chupachupbum/smart-coaster/docs/app-screens/01_dashboard.png

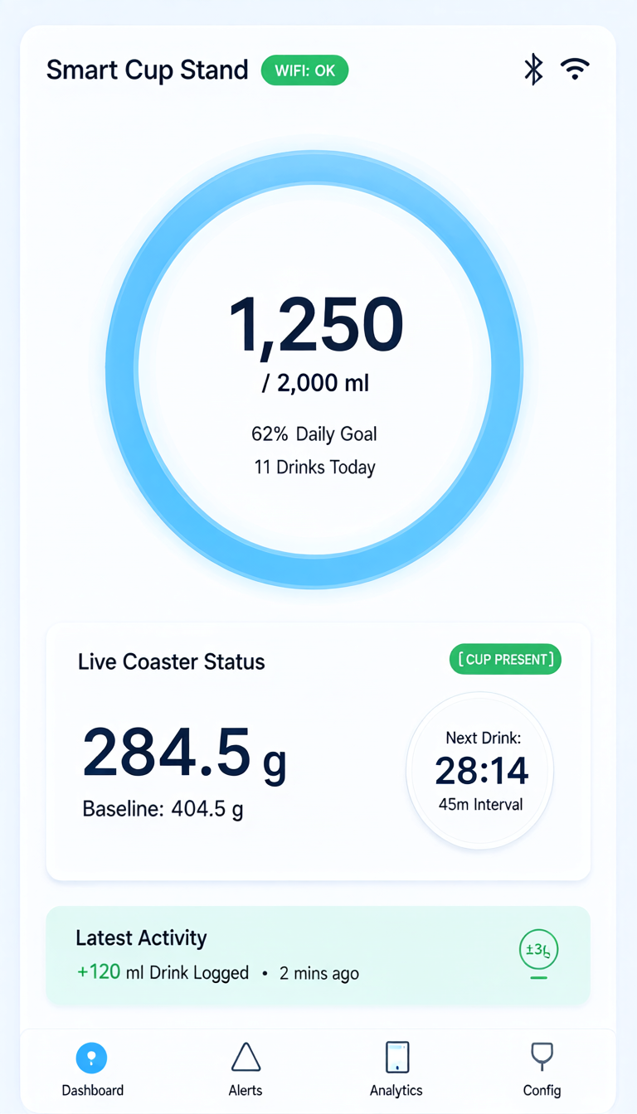
docs/app-screens/01_dashboard.png
