chupachupbum/smart-coaster/docs/app-screens/02_notifications.png

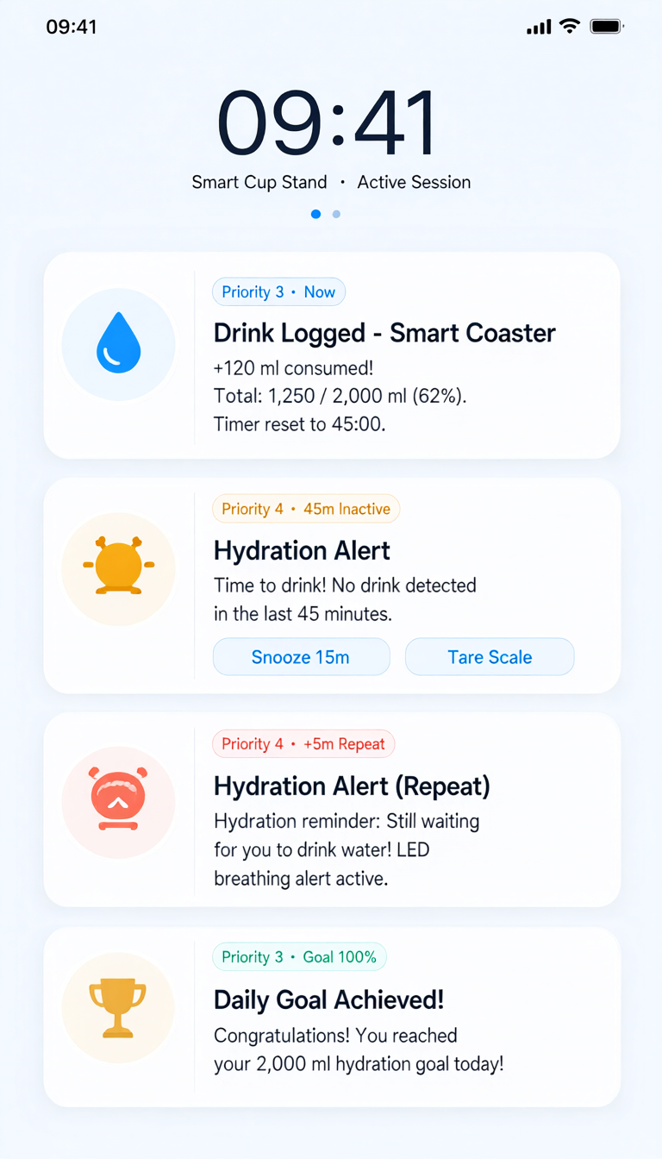
docs/app-screens/02_notifications.png
