chupachupbum/smart-coaster/docs/app-screens/03_charts_analytics.png

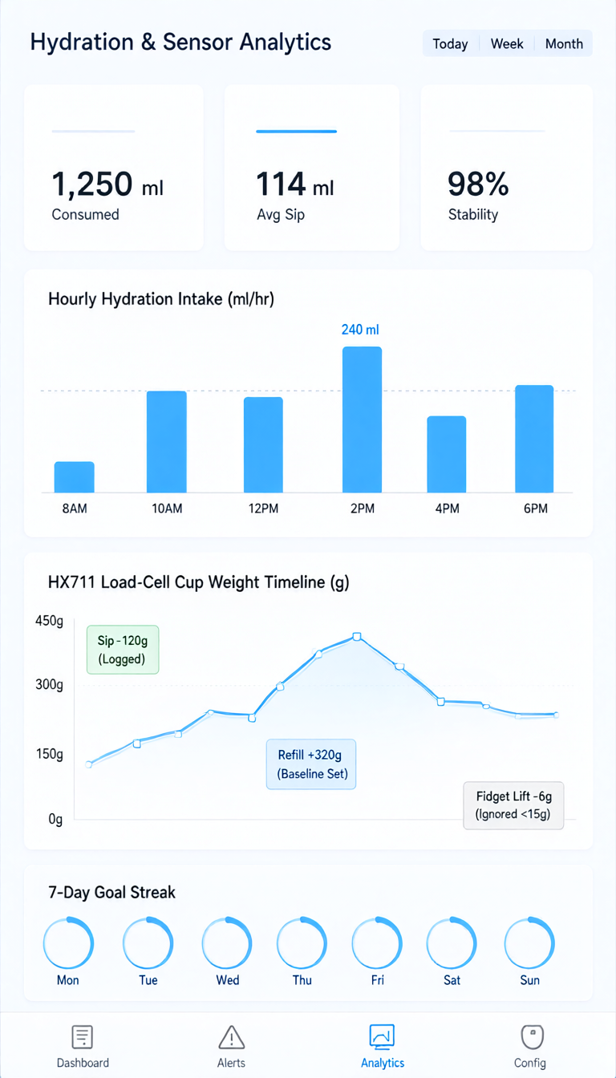
docs/app-screens/03_charts_analytics.png
