chupachupbum/smart-coaster/docs/app-screens/04_configuration.png

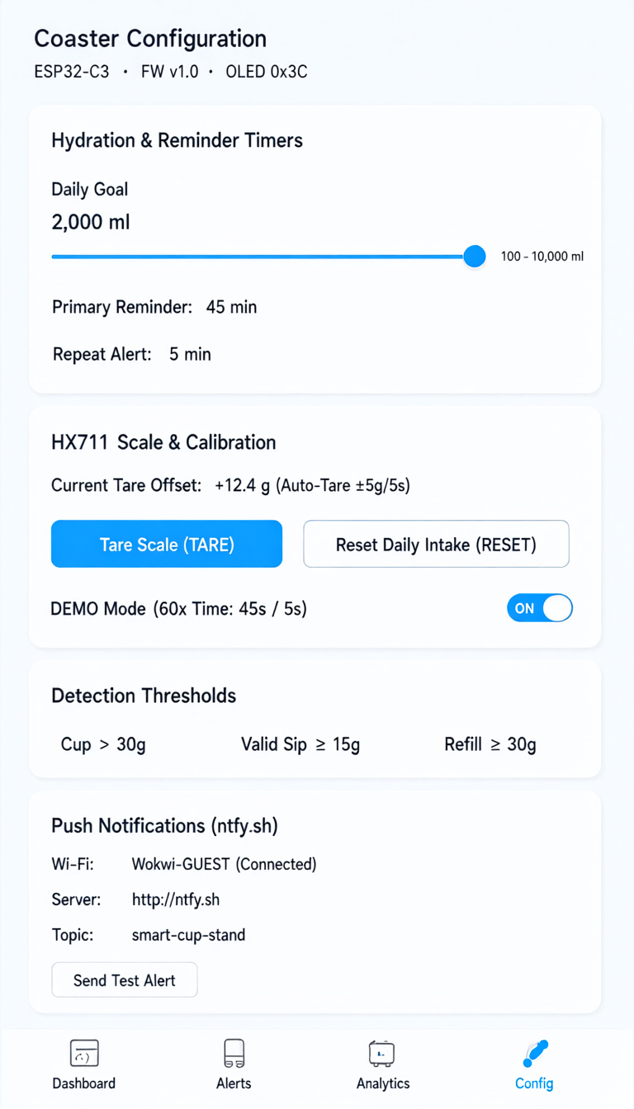
docs/app-screens/04_configuration.png
