chupachupbum/smart-coaster/schematic.jpeg

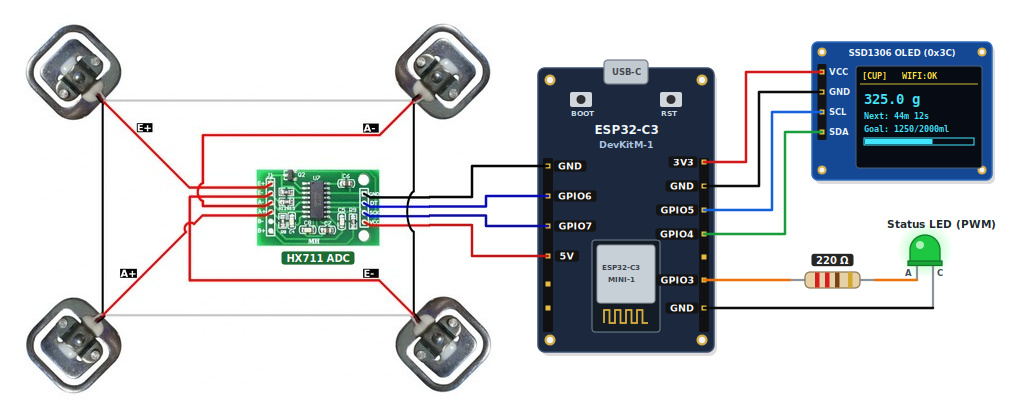
schematic.jpeg
