chupachupbum/smart-coaster/schematic_round_coaster.jpeg

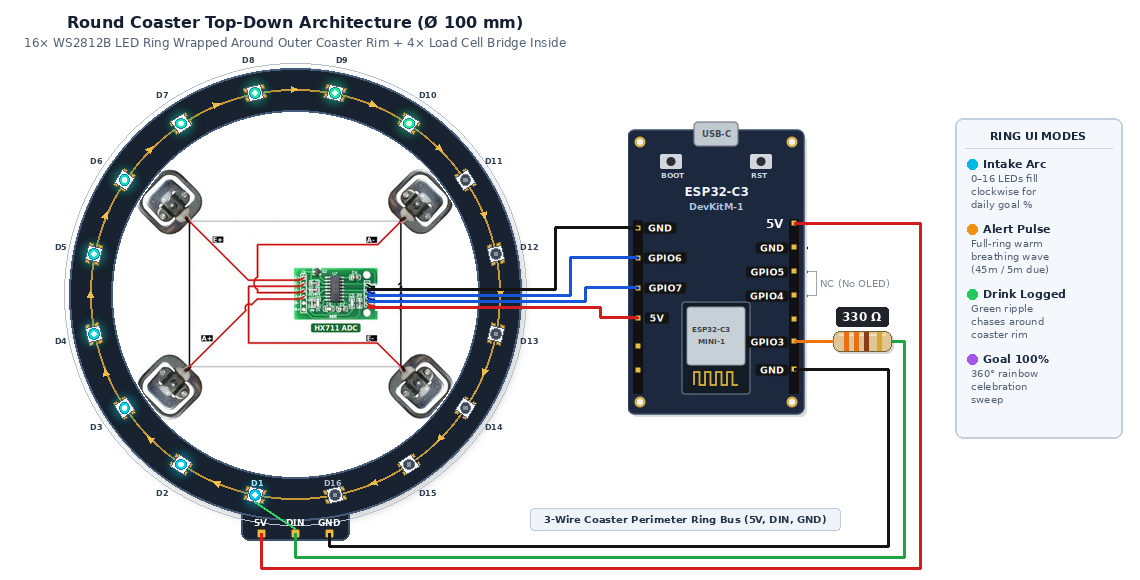
schematic_round_coaster.jpeg
