chupachupbum/smart-coaster/hardware/smart_cup_stand_pcb/manufacturing/bom.csv

Reference | Value | Footprint | Quantity | LCSC Part Number
C1, C2, C3, C4 | 10uF | Capacitor_SMD:C_0805_2012Metric | 4 | C15850
C5, C6, C7, C8, C9, C10, C11 | 100nF | Capacitor_SMD:C_0603_1608Metric | 7 | C14663
J1 | TYPE-C-31-M-12 | Connector_USB:USB_C_Receptacle_HRO_TYPE-C-31-M-12 | 1 | C165948
J2 | Conn_01x04_Pin | Connector_PinHeader_2.54mm:PinHeader_1x04_P2.54mm_Horizontal | 1 | C492412
J3 | Conn_01x03_Pin | Connector_PinHeader_2.54mm:PinHeader_1x03_P2.54mm_Horizontal | 1 | C492411
Q1 | SS8550 | Package_TO_SOT_SMD:SOT-23 | 1 | C2145
R1, R2 | 5.1k | Resistor_SMD:R_0603_1608Metric | 2 | C23186
R3, R4, R5, R6 | 10k | Resistor_SMD:R_0603_1608Metric | 4 | C25804
R7 | 330 | Resistor_SMD:R_0603_1608Metric | 1 | C23138
R8 | 20k | Resistor_SMD:R_0603_1608Metric | 1 | C4184
R9 | 8.2k | Resistor_SMD:R_0603_1608Metric | 1 | C23254
R10, R11 | 100 | Resistor_SMD:R_0603_1608Metric | 2 | C22775
SW1, SW2 | SW_Push | Button_Switch_SMD:SW_SPST_TL3342 | 2 | C318884
U1 | ESP32-C3-WROOM-02 | RF_Module:ESP32-C3-WROOM-02 | 1 | C2934560
U2 | AMS1117-3.3 | Package_TO_SOT_SMD:SOT-223-3_TabPin2 | 1 | C6186
U3 | HX711 | Package_SO:SOIC-16_3.9x9.9mm_P1.27mm | 1 | C43656
