chupachupbum/smart-coaster/hardware/smart_cup_stand_pcb/manufacturing/renders/pcb_cad_3d_bottom.png

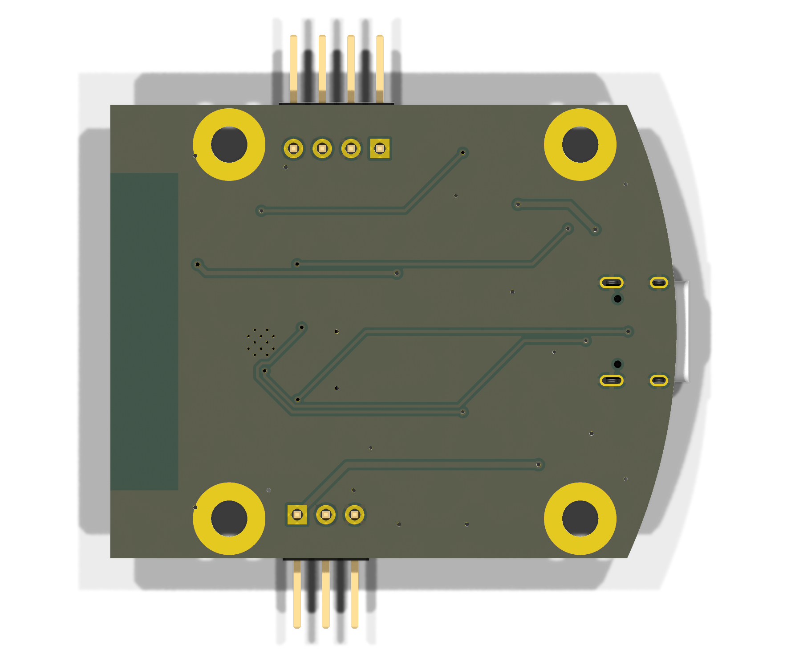
hardware/smart_cup_stand_pcb/manufacturing/renders/pcb_cad_3d_bottom.png
