chupachupbum/smart-coaster/hardware/smart_cup_stand_pcb/manufacturing/renders/pcb_reallife_top.jpg

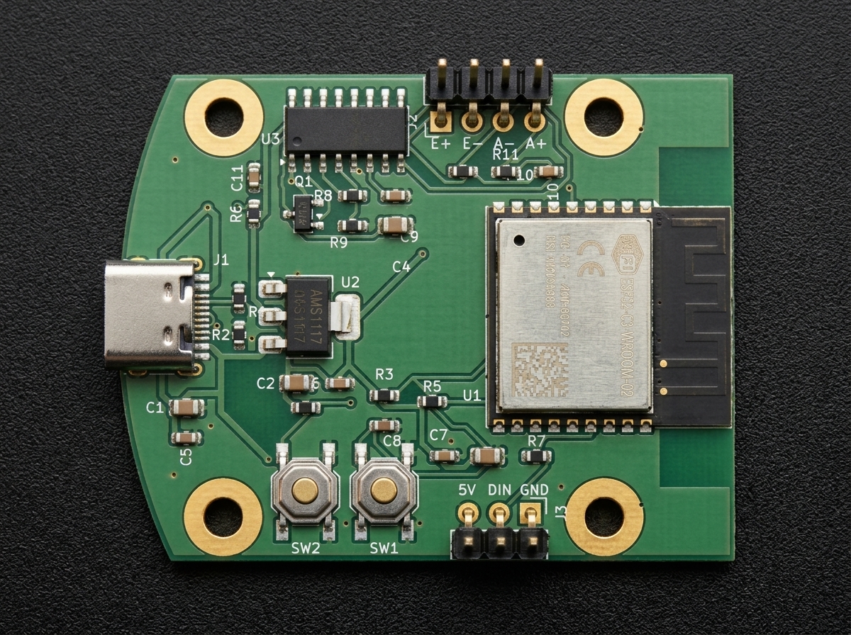
hardware/smart_cup_stand_pcb/manufacturing/renders/pcb_reallife_top.jpg
