chupachupbum/smart-coaster/hardware/smart_cup_stand_pcb/manufacturing/schematic.pdf

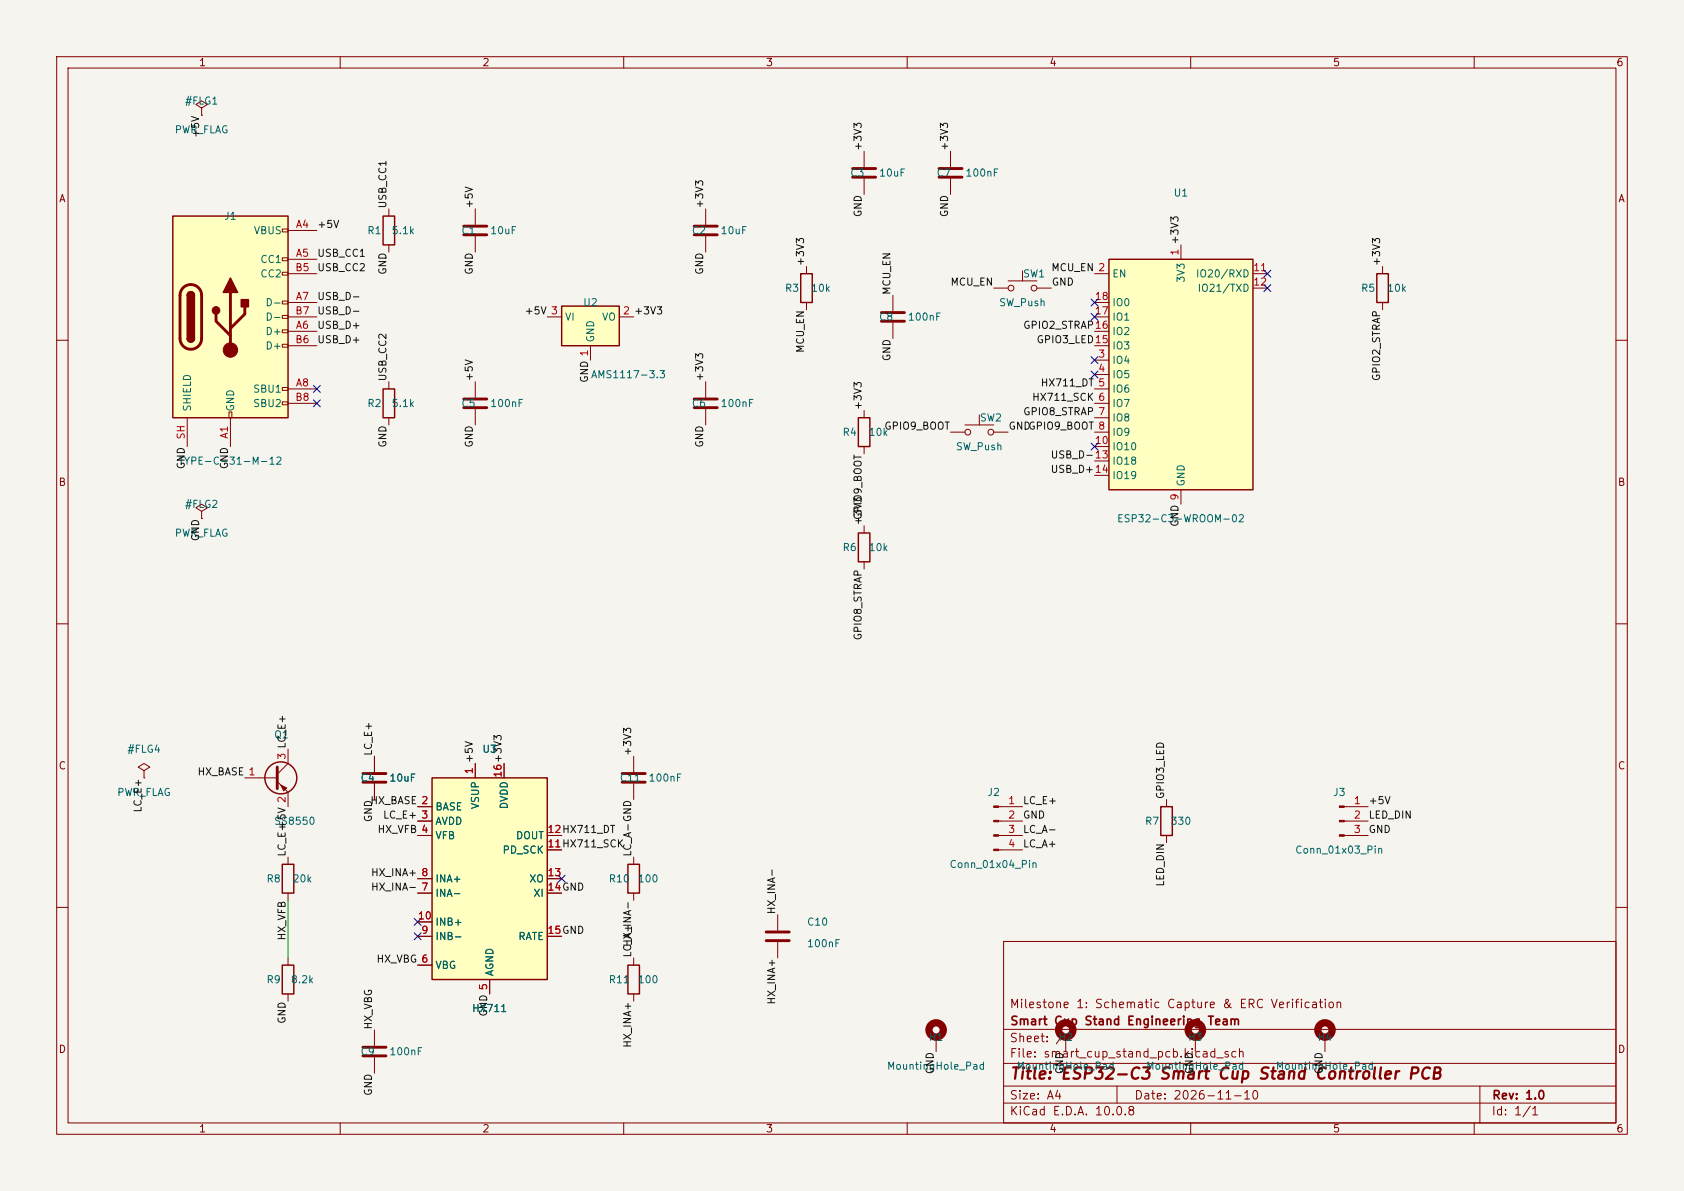
[picture p13: page 1]

Milestone 1: Schematic Capture & ERC Verification 3V3

Smart Cup Stand Engineering Team
Sheet: /
File: smart_cup_stand_pcb.kicad_sch
Title: ESP32-C3 Smart Cup Stand Controller PCB

Size: A4 | Rev: 1.0
KiCad E.D.A. 10.0.8 | Id: 1/1
