chupachupbum/smart-coaster/hardware/smart_cup_stand_pcb/manufacturing/pcb.pdf

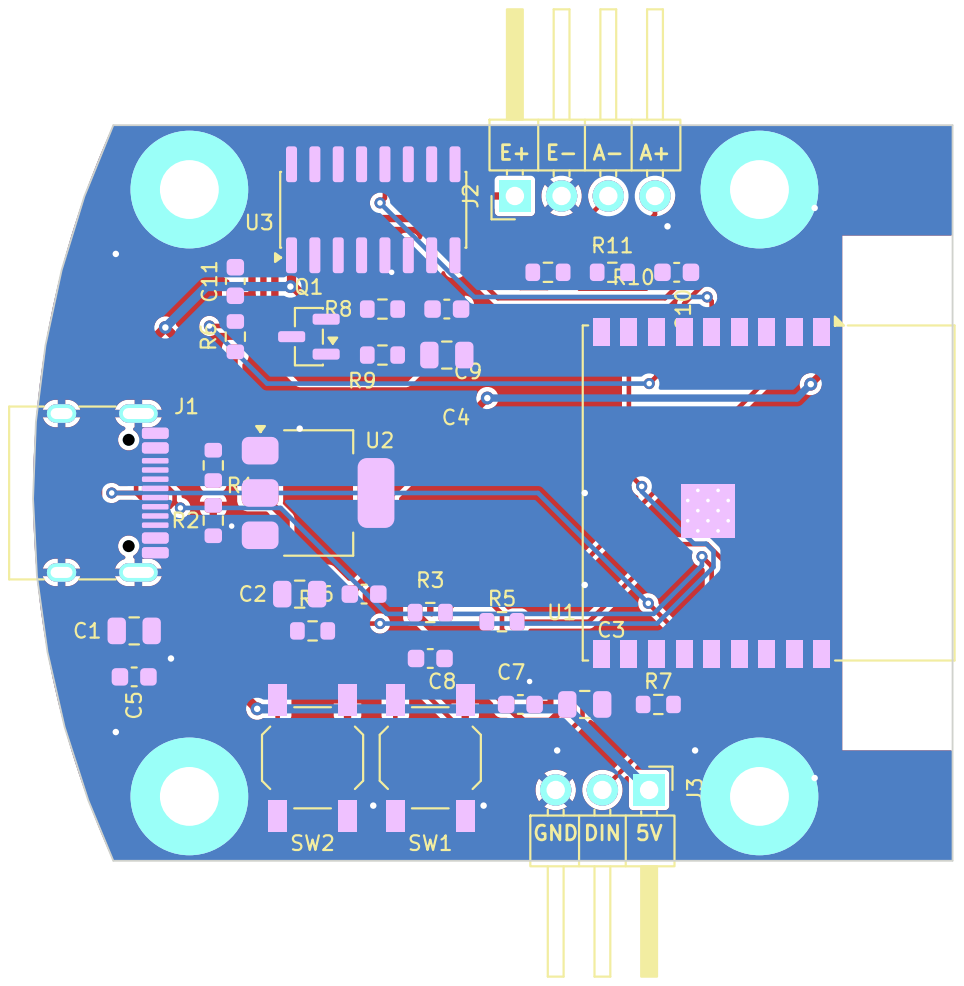
[picture p14: page 1]
