chupachupbum/smart-coaster/(list of files, drawings)

Other design files:
hardware/smart_cup_stand_pcb/manufacturing/pcb_quality_gate.json
hardware/smart_cup_stand_pcb/manufacturing/schematic_quality_gate.json
