chupachupbum/smart-coaster/hardware/smart_cup_stand_pcb/smart_cup_stand_pcb.kicad_pcb

## KiCad design hardware/smart_cup_stand_pcb/smart_cup_stand_pcb.kicad_pcb (2026-11-11)

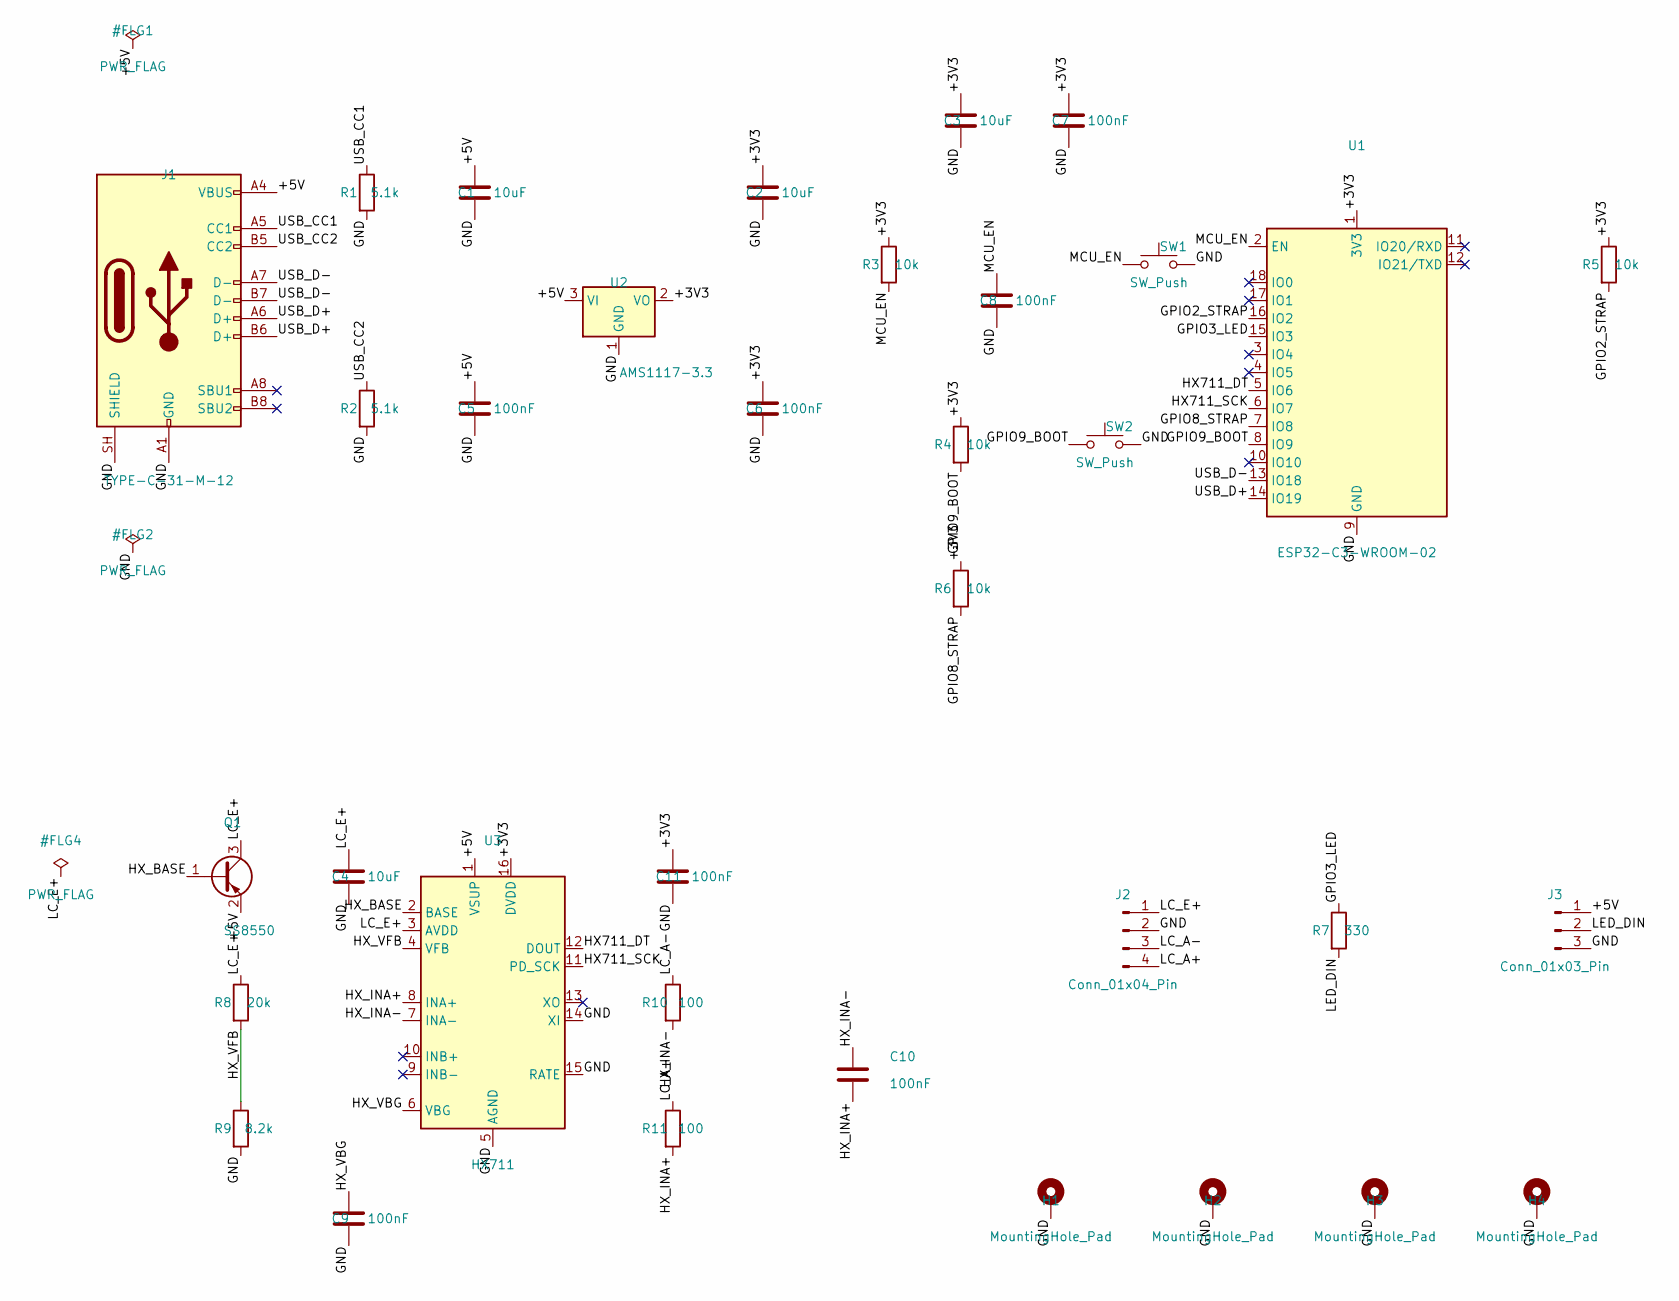
[picture p15: schematic smart_cup_stand_pcb.kicad_sch, ESP32-C3 Smart Cup Stand Controller PCB]

Parts:
C1, C2, C3, C4: 10uF; C_0805_2012Metric; LCSC C15850
C5, C6, C7, C8, C9, C10, C11: 100nF; C_0603_1608Metric; LCSC C14663
H1, H2, H3, H4: MountingHole_Pad; MountingHole_3.2mm_M3_Pad
J1: TYPE-C-31-M-12; USB_C_Receptacle_HRO_TYPE-C-31-M-12; LCSC C165948
J2: Conn_01x04_Pin; PinHeader_1x04_P2.54mm_Horizontal; LCSC C492412
J3: Conn_01x03_Pin; PinHeader_1x03_P2.54mm_Horizontal; LCSC C492411
Q1: SS8550; SOT-23; LCSC C2145
R1, R2: 5.1k; R_0603_1608Metric; LCSC C23186
R3, R4, R5, R6: 10k; R_0603_1608Metric; LCSC C25804
R7: 330; R_0603_1608Metric; LCSC C23138
R8: 20k; R_0603_1608Metric; LCSC C4184
R9: 8.2k; R_0603_1608Metric; LCSC C23254
R10, R11: 100; R_0603_1608Metric; LCSC C22775
SW1, SW2: SW_Push; SW_SPST_TL3342; LCSC C318884
U1: ESP32-C3-WROOM-02; LCSC C2934560
U2: AMS1117-3.3; SOT-223-3_TabPin2; LCSC C6186
U3: HX711; SOIC-16_3.9x9.9mm_P1.27mm; LCSC C43656

Connections:
+3V3: C2.1, C3.1, C6.1, C7.1, C11.1, R3.1, R4.1, R5.1, R6.1, U1.1 (3V3), U2.2 (VO), U3.16 (DVDD)
+5V: C1.1, C5.1, J1.A4 (VBUS), J1.A9 (VBUS), J1.B4 (VBUS), J1.B9 (VBUS), J3.1, Q1.2 (E), U2.3 (VI), U3.1 (VSUP)
GND: C1.2, C2.2, C3.2, C4.2, C5.2, C6.2, C7.2, C8.2, C9.2, C11.2, H1.1, H2.1, H3.1, H4.1, J1.A1 (GND), J1.A12 (GND), J1.B1 (GND), J1.B12 (GND), J1.SH (SHIELD), J2.2, J3.3, R1.2, R2.2, R9.2, SW1.2, SW2.2, U1.9 (GND), U1.19 (GND), U2.1 (GND), U3.5 (AGND), U3.14 (XI), U3.15 (RATE)
GPIO2_STRAP: R5.2, U1.16 (IO2)
GPIO3_LED: R7.1, U1.15 (IO3)
GPIO8_STRAP: R6.2, U1.7 (IO8)
GPIO9_BOOT: R4.2, SW2.1, U1.8 (IO9)
HX711_DT: U1.5 (IO6), U3.12 (DOUT)
HX711_SCK: U1.6 (IO7), U3.11 (PD_SCK)
HX_BASE: Q1.1 (B), U3.2 (BASE)
HX_INA+: C10.2, R11.2, U3.8 (INA+)
HX_INA-: C10.1, R10.2, U3.7 (INA-)
HX_VBG: C9.1, U3.6 (VBG)
HX_VFB: R8.2, R9.1, U3.4 (VFB)
LC_A+: J2.4, R11.1
LC_A-: J2.3, R10.1
LC_E+: C4.1, J2.1, Q1.3 (C), R8.1, U3.3 (AVDD)
LED_DIN: J3.2, R7.2
MCU_EN: C8.1, R3.2, SW1.1, U1.2 (EN)
USB_CC1: J1.A5 (CC1), R1.1
USB_CC2: J1.B5 (CC2), R2.1
USB_D+: J1.A6 (D+), J1.B6 (D+), U1.14 (IO19)
USB_D-: J1.A7 (D-), J1.B7 (D-), U1.13 (IO18)

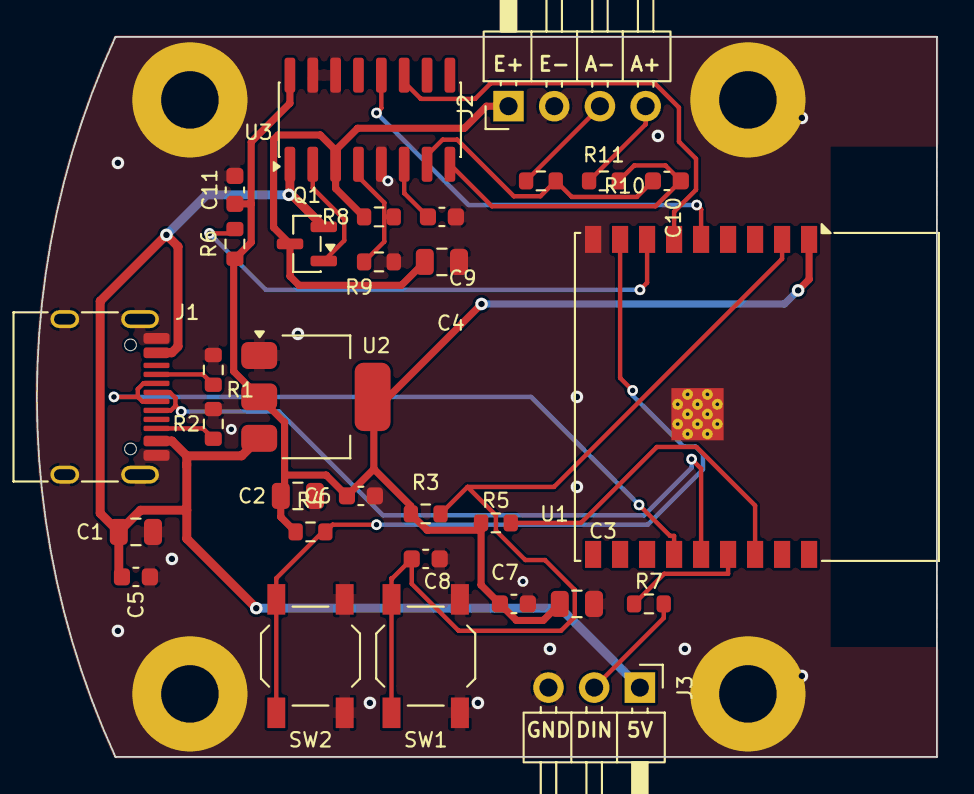
[picture p16: board smart_cup_stand_pcb.kicad_pcb from above]

Board: 2 copper layers, 50.0 x 40.0 mm, 35 parts (0 on the bottom side), 23 nets.
