chupachupbum/smart-coaster/include/secrets.example.h

#ifndef SECRETS_H_
#define SECRETS_H_

// ============================================================================
// Local Wi-Fi & Notification Secrets Template
// Copy this file to `include/secrets.h` (gitignored) for hardware deployments.
// ============================================================================

#define WIFI_SSID           "your-wifi-ssid"
#define WIFI_PASSWORD       "your-wifi-password"

// Use a unique, hard-to-guess topic name on ntfy.sh (or a self-hosted URL)
#define NTFY_SERVER_URL     "http://ntfy.sh"
#define NTFY_DEFAULT_TOPIC  "smart-coaster-your-secret-topic"

#endif // SECRETS_H_
