chupachupbum/smart-coaster/(commit log)

2026-11-04 feat: initial ESP32-C3 smart coaster firmware, schematic, README, and test suite
2026-11-06 feat(board): add classic ESP32 esp32dev hardware profile
2026-11-10 feat: add KiCad PCB, LED ring layouts, and app UI
    [bom.csv, jlcpcb_bom.csv, pcb_quality_gate.json, schematic_quality_gate.json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]
2026-11-11 feat(pcb): redesign to 50x40mm D-shape layout
    Fits 100mm round enclosure with R=48mm USB-C arc edge and horizontal
    right-angle headers (J2 C492412, J3 C492411) to reduce vertical height.
    [bom.csv, jlcpcb_bom.csv, pcb_quality_gate.json, schematic_quality_gate.json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]
2026-11-11 refactor(pcb): move U1 flush right and J2/J3 N/S
    Keep FR-4, copper pours, header pins, and wire harnesses out of U1's
    2.4 GHz radiation lobe while isolating microvolt HX711 bridge lines
    from RF bursts and WS2812 switching current.
    - Shift H2 and H3 1.36 mm left to x = 139.50 mm to clear U1 keepout
    - Map LC_E+ to 0.40 mm Power_3V3 netclass and regenerate JLCPCB files
    [pcb_quality_gate.json, schematic_quality_gate.json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]
2026-11-13 feat(fw): add NeoPixel ring, Wi-Fi portal, and tap gesture
    Replace OLED/status LED output with 16-pixel WS2812B LedRing driver,
    add captive-portal Wi-Fi provisioning + NVS persistence + ntfy retries,
    support 3-tap load-cell goal reset, and update unit/E2E tests and README.
    [config.h, empirical_adversarial_harness.cpp, empirical_event_pump_harness.cpp, led_ring.cpp, led_ring.h, main.cpp, network_push.cpp]
